shamakg/hope-pager/libs-updated/3dmodels/USB4085-GF-A_REVB.step

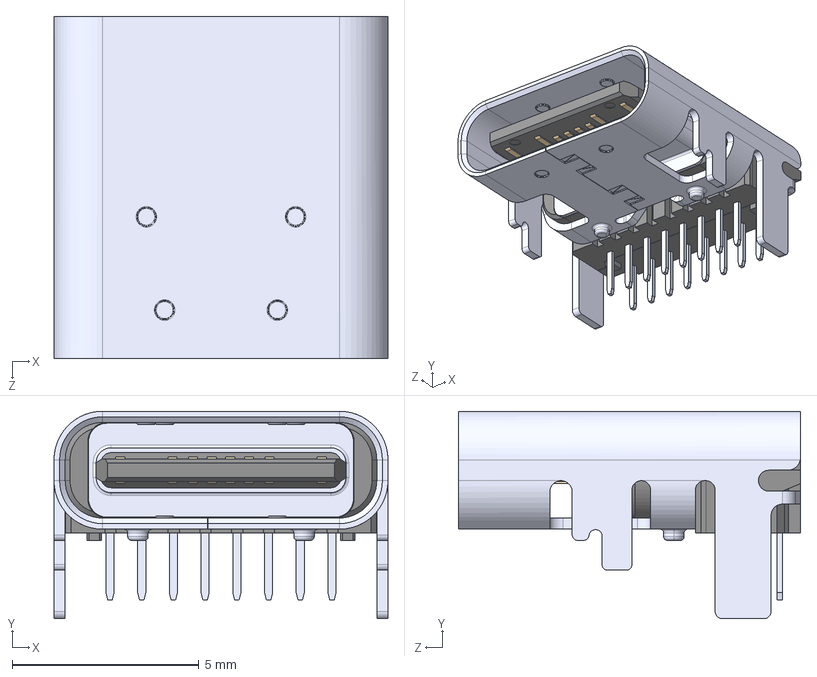
[picture p1: CAD file, 2026-10-16]
libs-updated/3dmodels/USB4085-GF-A_REVB.step
8.95 x 5.56 x 9.17 mm
