shamakg/hope-pager/libs-updated/AT-1220-TT-R.step

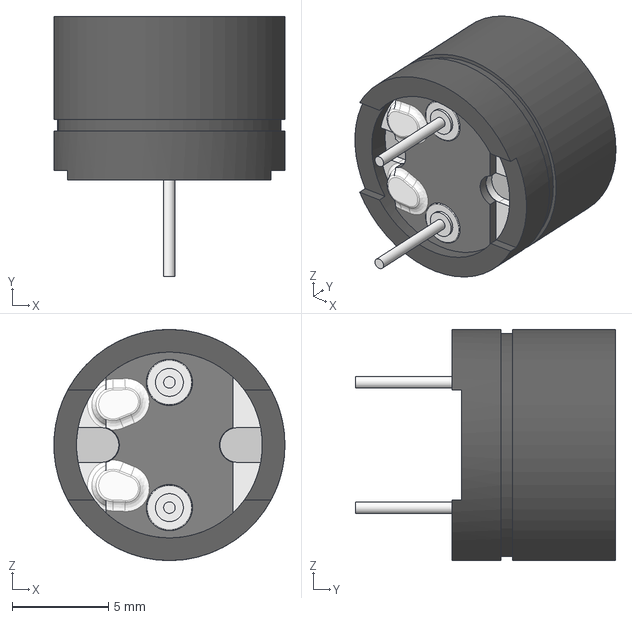
[picture p2: CAD file, 2026-10-29]
libs-updated/AT-1220-TT-R.step
12.0 x 13.5 x 12.0 mm
