shamakg/hope-pager/Pager-updated/Pager.kicad_pcb

## KiCad design Pager-updated/Pager.kicad_pcb (2026-11-06)

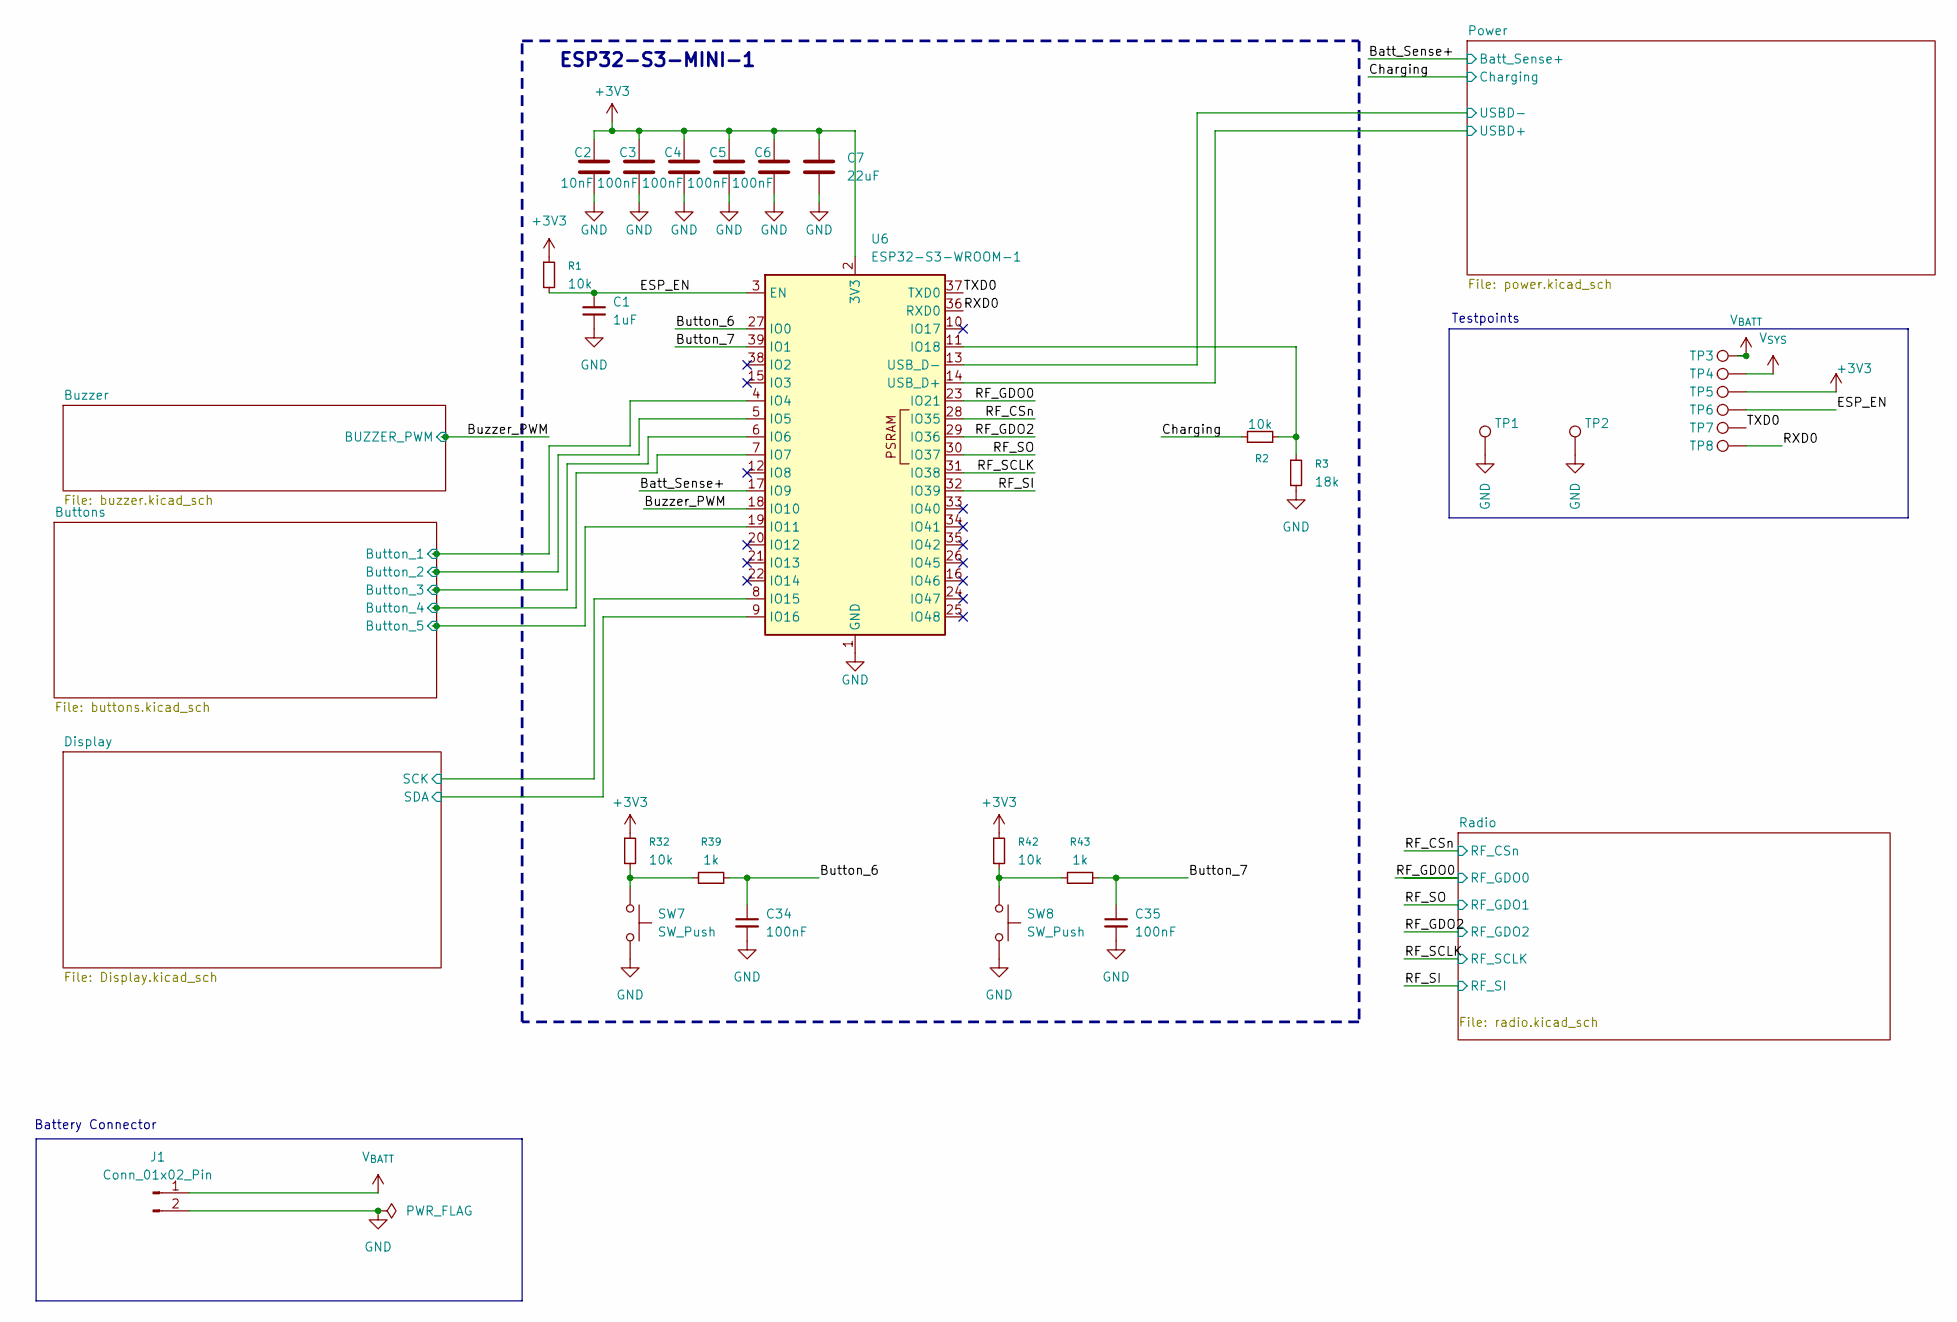
[picture p3: schematic Pager.kicad_sch]

Parts:
C1: 1uF; C_0805_2012Metric_Pad1.18x1.45mm_HandSolder
C2: 10nF; C_0805_2012Metric_Pad1.18x1.45mm_HandSolder
C3, C4, C5, C6: 100nF; C_0805_2012Metric_Pad1.18x1.45mm_HandSolder
C7: 22uF; C_0805_2012Metric_Pad1.18x1.45mm_HandSolder
C34, C35: 100nF; C_0603_1608Metric
J1: Conn_01x02_Pin; JST_PH_S2B-PH-SM4-TB_1x02-1MP_P2.00mm_Horizontal
R1, R2: 10k; R_0805_2012Metric_Pad1.20x1.40mm_HandSolder
R3: 18k; R_0805_2012Metric_Pad1.20x1.40mm_HandSolder
R32, R42: 10k; R_0603_1608Metric
R39, R43: 1k; R_0603_1608Metric
SW7, SW8: SW_Push; SW_PUSH_6mm
TP1, TP2, TP3, TP4, TP5, TP6, TP7, TP8: TestPoint; TestPoint_Pad_D1.5mm
U6: ESP32-S3-WROOM-1; ESP32-S3-WROOM-1U

Connections:
+3V3: C2.1, C3.1, C4.1, C5.1, C6.1, C7.1, R1.1, R32.1, R42.1, TP5.1 (1_1), U6.2 (3V3); also elsewhere on the board
/Batt_Sense+: U6.17 (IO9); also elsewhere on the board
/Button_6: C34.1, R39.2, U6.27 (IO0)
/Button_7: C35.1, R43.2, U6.39 (IO1)
/Buttons/Button_1: U6.4 (IO4); also elsewhere on the board
/Buttons/Button_2: U6.5 (IO5); also elsewhere on the board
/Buttons/Button_3: U6.6 (IO6); also elsewhere on the board
/Buttons/Button_4: U6.7 (IO7); also elsewhere on the board
/Buttons/Button_5: U6.19 (IO11); also elsewhere on the board
/Buzzer_PWM: U6.18 (IO10); also elsewhere on the board
/Charging: R2.1; also elsewhere on the board
/Display/SCK: U6.8 (IO15); also elsewhere on the board
/Display/SDA: U6.9 (IO16); also elsewhere on the board
/ESP_EN: C1.1, R1.2, TP6.1 (1_1), U6.3 (EN)
/Power/USBD+: U6.14 (USB_D+); also elsewhere on the board
/Power/USBD-: U6.13 (USB_D-); also elsewhere on the board
/RF_CSn: U6.28 (IO35); also elsewhere on the board
/RF_GDO0: U6.23 (IO21); also elsewhere on the board
/RF_GDO2: U6.29 (IO36); also elsewhere on the board
/RF_SCLK: U6.31 (IO38); also elsewhere on the board
/RF_SI: U6.32 (IO39); also elsewhere on the board
/RF_SO: U6.30 (IO37); also elsewhere on the board
/RXD0: TP8.1 (1_1), U6.36 (RXD0)
/TXD0: TP7.1 (1_1), U6.37 (TXD0)
GND: C1.2, C2.2, C3.2, C4.2, C5.2, C6.2, C7.2, C34.2, C35.2, J1.2, R3.2, SW7.2, SW8.2, TP1.1 (1_1), TP2.1 (1_1), U6.1 (GND), U6.40 (GND), U6.41 (GND); also elsewhere on the board
unnamed: R32.2, R39.1, SW7.1
unnamed: R42.2, R43.1, SW8.1
unnamed: R2.2, R3.1, U6.11 (IO18)
V_{BATT}: J1.1, TP3.1 (1_1); also elsewhere on the board
V_{SYS}: TP4.1 (1_1); also elsewhere on the board

Notes on the sheet:
Battery Connector
ESP32-S3-MINI-1
Testpoints

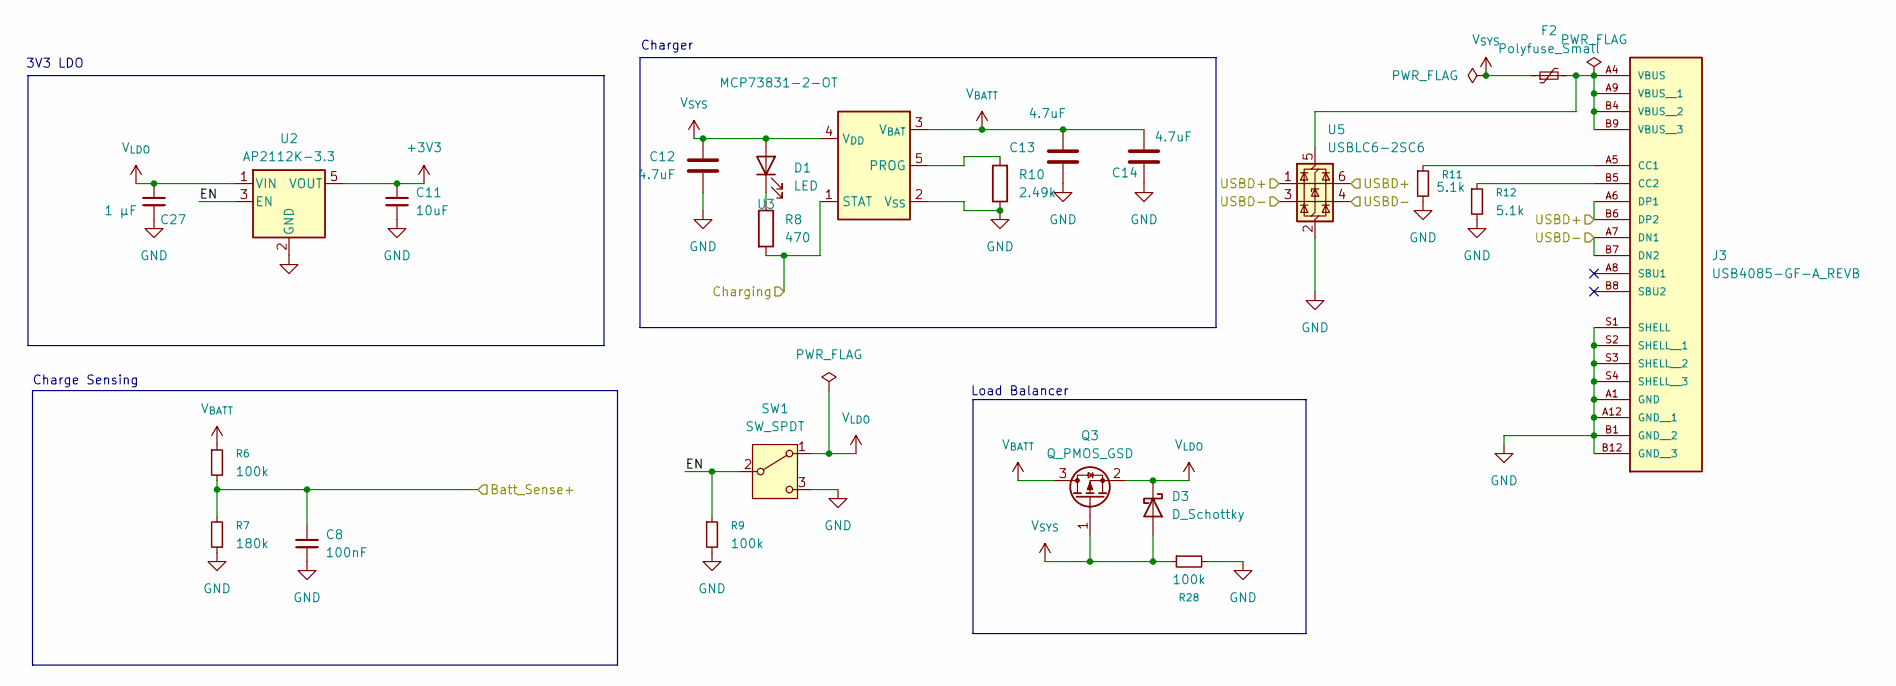
[picture p4: schematic power.kicad_sch]

Parts:
C8: 100nF; C_0805_2012Metric_Pad1.18x1.45mm_HandSolder
C11: 10uF; C_0805_2012Metric_Pad1.18x1.45mm_HandSolder
C12, C13, C14: 4.7uF; C_0805_2012Metric_Pad1.18x1.45mm_HandSolder
C27: 1 µF; C_0805_2012Metric_Pad1.18x1.45mm_HandSolder
D1: LED; LED_0603_1608Metric
D3: D_Schottky; D_SOD-123
F2: Polyfuse_Small; Fuse_1206_3216Metric
J3: USB4085-GF-A_REVB; GCT_USB4085-GF-A_REVB; PARTREV B
Q3: Q_PMOS_GSD; SOT-523
R6, R9, R28: 100k; R_0805_2012Metric_Pad1.20x1.40mm_HandSolder
R7: 180k; R_0805_2012Metric_Pad1.20x1.40mm_HandSolder
R8: 470; R_0805_2012Metric_Pad1.20x1.40mm_HandSolder
R10: 2.49k; R_0805_2012Metric_Pad1.20x1.40mm_HandSolder
R11, R12: 5.1k; R_0805_2012Metric_Pad1.20x1.40mm_HandSolder
SW1: SW_SPDT; SW_Slide_SPDT_Straight_CK_OS102011MS2Q
U2: AP2112K-3.3; SOT-23-5
U3: MCP73831-2-OT; SOT-23-5
U5: USBLC6-2SC6; SOT-23-6

Connections:
+3V3: C11.1, U2.5 (VOUT); also elsewhere on the board
/Batt_Sense+: C8.2, R6.2, R7.2; also elsewhere on the board
/Charging: R8.2, U3.1 (STAT); also elsewhere on the board
/Power/EN: R9.1, SW1.2 (B), U2.3 (EN)
/Power/USBD+: J3.A6 (DP1), J3.B6 (DP2), U5.1 (I/O1), U5.6 (I/O1); also elsewhere on the board
/Power/USBD-: J3.A7 (DN1), J3.B7 (DN2), U5.3 (I/O2), U5.4 (I/O2); also elsewhere on the board
GND: C8.1, C11.2, C12.1, C13.1, C14.1, C27.2, J3.A1 (GND), J3.A12 (GND__1), J3.B1 (GND__2), J3.B12 (GND__3), J3.S1 (SHELL), J3.S2 (SHELL__1), J3.S3 (SHELL__2), J3.S4 (SHELL__3), R7.1, R9.2, R10.1, R11.2, R12.2, R28.2, SW1.3 (C), U2.2 (GND), U3.2 (V_{SS}), U5.2 (GND); also elsewhere on the board
unnamed: D1.1 (K), R8.1
unnamed: J3.A5 (CC1), R11.1
unnamed: J3.B5 (CC2), R12.1
unnamed: F2.2, J3.A4 (VBUS), J3.A9 (VBUS__1), J3.B4 (VBUS__2), J3.B9 (VBUS__3), U5.5 (VBUS)
unnamed: R10.2, U3.5 (PROG)
V_{BATT}: C13.2, C14.2, Q3.3 (D), R6.1, U3.3 (V_{BAT}); also elsewhere on the board
V_{LDO}: C27.1, D3.1 (K), Q3.2 (S), SW1.1 (A), U2.1 (VIN)
V_{SYS}: C12.2, D1.2 (A), D3.2 (A), F2.1, Q3.1 (G), R28.1, U3.4 (V_{DD}); also elsewhere on the board

Notes on the sheet:
3V3 LDO
Load Balancer
Charge Sensing
Charger

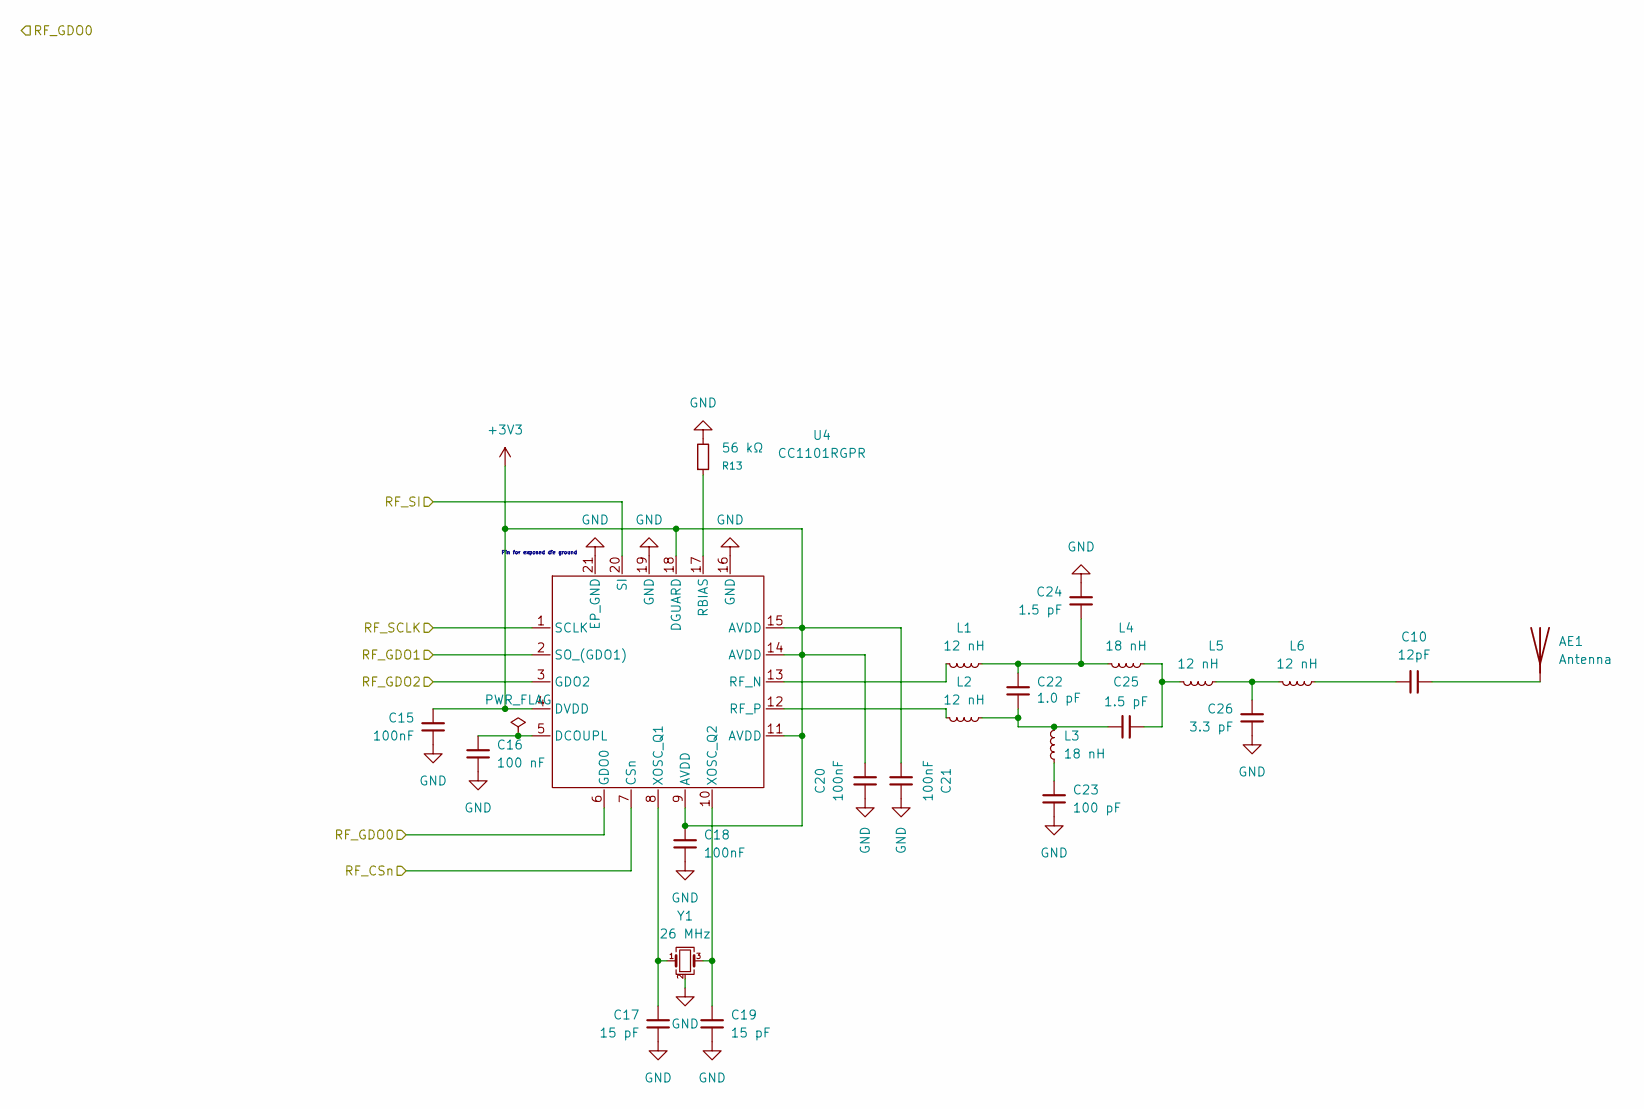
[picture p5: schematic radio.kicad_sch]

Parts:
AE1: Antenna; ANT_0915AT43A0026E_JOT
C10: 12pF; C_0805_2012Metric_Pad1.18x1.45mm_HandSolder
C15, C18, C20, C21: 100nF; C_0805_2012Metric_Pad1.18x1.45mm_HandSolder
C16: 100 nF; C_0805_2012Metric_Pad1.18x1.45mm_HandSolder
C17, C19: 15 pF; C_0805_2012Metric_Pad1.18x1.45mm_HandSolder
C22: 1.0 pF; C_0805_2012Metric_Pad1.18x1.45mm_HandSolder
C23: 100 pF; C_0805_2012Metric_Pad1.18x1.45mm_HandSolder
C24, C25: 1.5 pF; C_0805_2012Metric_Pad1.18x1.45mm_HandSolder
C26: 3.3 pF; C_0805_2012Metric_Pad1.18x1.45mm_HandSolder
L1, L2, L5, L6: 12 nH; L_0805_2012Metric_Pad1.05x1.20mm_HandSolder
L3, L4: 18 nH; L_0805_2012Metric_Pad1.05x1.20mm_HandSolder
R13: 56 kΩ; R_0805_2012Metric_Pad1.20x1.40mm_HandSolder
U4: CC1101RGPR; Texas_RGP0020H_VQFN-20-1EP_4x4mm_P0.5mm_EP2.4x2.4mm_Thermal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
Y1: 26 MHz; Crystal_SMD_3225-4Pin_3.2x2.5mm

Connections:
+3V3: C15.1, C18.1, C20.2, C21.1, U4.4 (DVDD), U4.9 (AVDD), U4.11 (AVDD), U4.14 (AVDD), U4.15 (AVDD), U4.18 (DGUARD); also elsewhere on the board
/RF_CSn: U4.7 (CSn); also elsewhere on the board
/RF_GDO0: U4.6 (GDO0); also elsewhere on the board
/RF_GDO2: U4.3 (GDO2); also elsewhere on the board
/RF_SCLK: U4.1 (SCLK); also elsewhere on the board
/RF_SI: U4.20 (SI); also elsewhere on the board
/RF_SO: U4.2 (SO_(GDO1)); also elsewhere on the board
GND: C15.2, C16.2, C17.2, C18.2, C19.2, C20.1, C21.2, C23.2, C24.2, C26.1, R13.2, U4.16 (GND), U4.19 (GND), U4.21 (EP_GND), Y1.2 (G), Y1.4 (G); also elsewhere on the board
unnamed: AE1.1 (A_1), C10.2
unnamed: C10.1, L6.1
unnamed: C22.1, C24.1, L1.1, L4.2
unnamed: C22.2, C25.1, L2.1, L3.2
unnamed: C23.1, L3.1
unnamed: C25.2, L4.1, L5.2
unnamed: C26.2, L5.1, L6.2
unnamed: C16.1, U4.5 (DCOUPL)
unnamed: R13.1, U4.17 (RBIAS)
unnamed: L1.2, U4.13 (RF_N)
unnamed: L2.2, U4.12 (RF_P)
unnamed: C17.1, U4.8 (XOSC_Q1), Y1.1
unnamed: C19.1, U4.10 (XOSC_Q2), Y1.3

Notes on the sheet:
Pin for exposed die ground

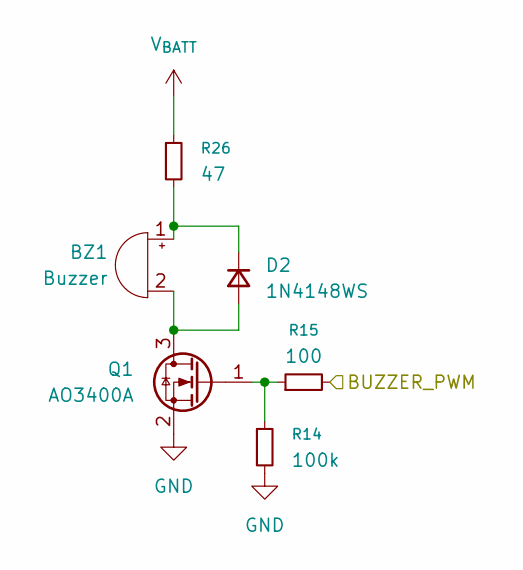
[picture p6: schematic buzzer.kicad_sch]

Parts:
BZ1: Buzzer; XDCR_AT-1220-TT-R
D2: 1N4148WS; D_SOD-323
Q1: AO3400A; SOT-23
R14: 100k; R_0805_2012Metric_Pad1.20x1.40mm_HandSolder
R15: 100; R_0805_2012Metric_Pad1.20x1.40mm_HandSolder
R26: 47; R_0805_2012Metric_Pad1.20x1.40mm_HandSolder

Connections:
/Buzzer_PWM: R15.2; also elsewhere on the board
GND: Q1.2 (S), R14.2; also elsewhere on the board
unnamed: BZ1.1 (+), D2.1 (K), R26.2
unnamed: BZ1.2 (-), D2.2 (A), Q1.3 (D)
unnamed: Q1.1 (G), R14.1, R15.1
V_{BATT}: R26.1; also elsewhere on the board

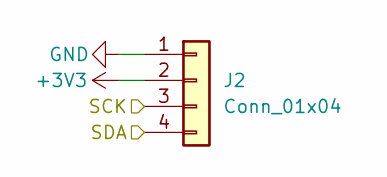
[picture p7: schematic Display.kicad_sch]

Parts:
J2: Conn_01x04; PinHeader_1x04_P2.54mm_Vertical

Connections:
+3V3: J2.2; also elsewhere on the board
/Display/SCK: J2.3; also elsewhere on the board
/Display/SDA: J2.4; also elsewhere on the board
GND: J2.1; also elsewhere on the board

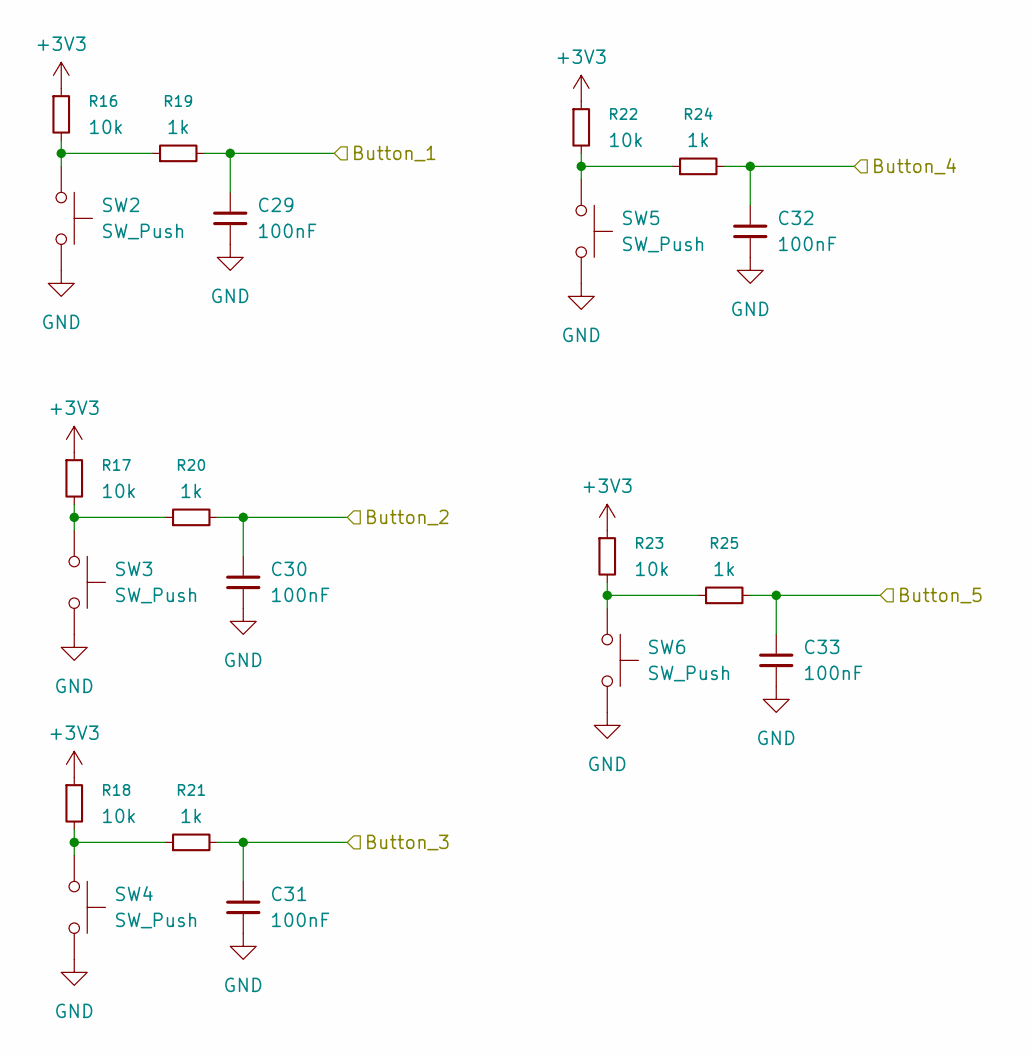
[picture p8: schematic buttons.kicad_sch]

Parts:
C29, C30, C31, C32, C33: 100nF; C_0805_2012Metric_Pad1.18x1.45mm_HandSolder
R16, R17, R18, R22, R23: 10k; R_0805_2012Metric_Pad1.20x1.40mm_HandSolder
R19, R20, R21, R24, R25: 1k; R_0805_2012Metric_Pad1.20x1.40mm_HandSolder
SW2, SW3, SW4, SW5, SW6: SW_Push; SW_PUSH_6mm

Connections:
+3V3: R16.1, R17.1, R18.1, R22.1, R23.1; also elsewhere on the board
/Buttons/Button_1: C29.1, R19.2; also elsewhere on the board
/Buttons/Button_2: C30.1, R20.2; also elsewhere on the board
/Buttons/Button_3: C31.1, R21.2; also elsewhere on the board
/Buttons/Button_4: C32.1, R24.2; also elsewhere on the board
/Buttons/Button_5: C33.1, R25.2; also elsewhere on the board
GND: C29.2, C30.2, C31.2, C32.2, C33.2, SW2.2, SW3.2, SW4.2, SW5.2, SW6.2; also elsewhere on the board
unnamed: R16.2, R19.1, SW2.1
unnamed: R17.2, R20.1, SW3.1
unnamed: R18.2, R21.1, SW4.1
unnamed: R22.2, R24.1, SW5.1
unnamed: R23.2, R25.1, SW6.1

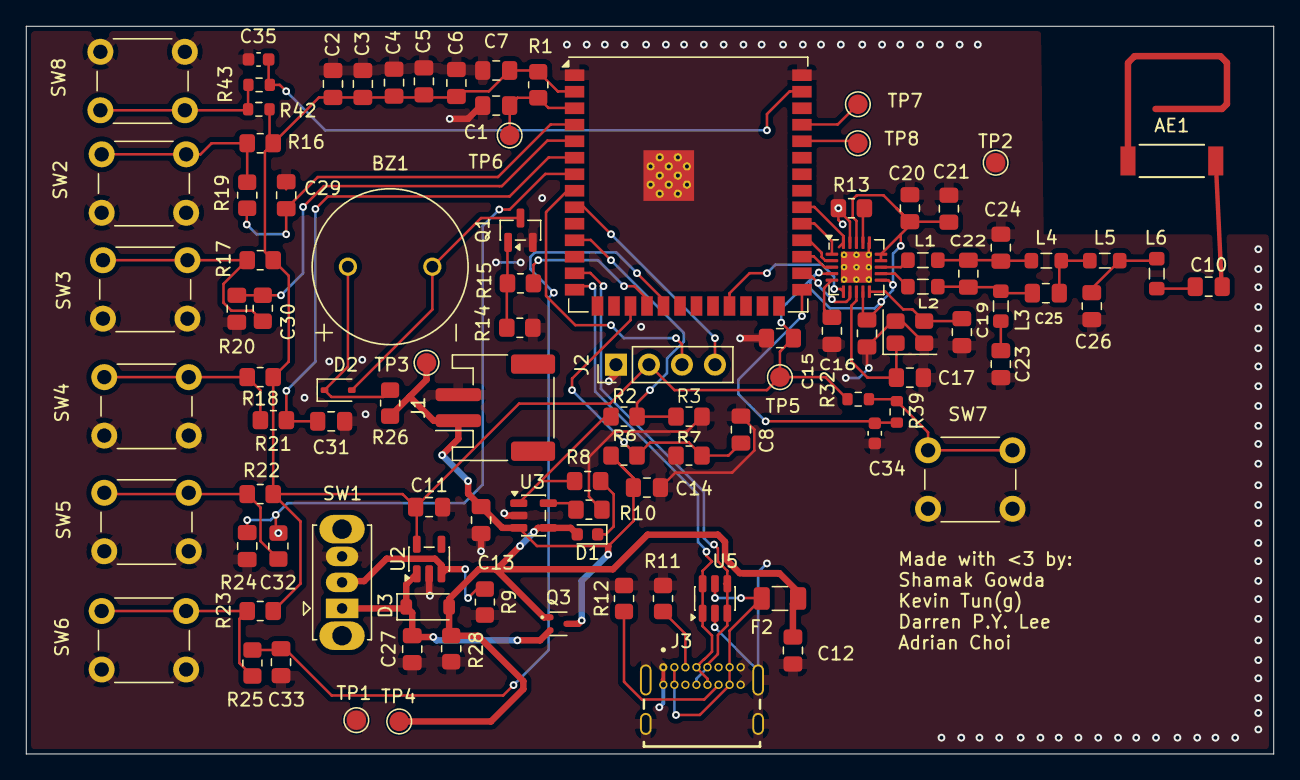
[picture p9: board Pager.kicad_pcb from above]

Board: 2 copper layers, 96.0 x 56.0 mm, 101 parts (0 on the bottom side), 58 nets.
