shamakg/hope-pager/(commit log)

2026-10-16 esp32 + crystal
    [Pager.kicad_pcb, Pager.kicad_sch, Untitled.kicad_pcb, Untitled.kicad_sch]
2026-10-16 removed Untitled
    [Untitled.kicad_pcb, Untitled.kicad_sch]
2026-10-16 bring all project files up a level
    [Pager.kicad_pcb, Pager.kicad_sch, power.kicad_sch]
2026-10-22 created new radio symbol and started on radio schem
    [radio.kicad_sch]
2026-10-23 add cap values
    [radio.kicad_sch]
2026-10-23 finish radio ic
    [radio.kicad_sch]
2026-10-23 finished radio module
    [Pager.kicad_sch, radio.kicad_sch]
2026-10-23 connected radio to mcu
    [Pager.kicad_sch, radio.kicad_sch]
2026-10-29 Schematic Review, Footprints Added, Need Screen
    [Display.kicad_sch, Pager.kicad_sch, buttons.kicad_sch, buzzer.kicad_sch, power.kicad_sch, radio.kicad_sch]
2026-10-30 add display module
    [Display.kicad_sch, Pager.kicad_sch]
2026-11-06 fixed power load balancing circuit
    [power.kicad_sch]
2026-11-06 fix vbus det line
    [Pager.kicad_sch, power.kicad_sch]
2026-11-06 fix radio schematic
    [Pager.kicad_sch, radio.kicad_sch]
2026-11-06 remove vbus detect
    [Pager.kicad_pcb, Pager.kicad_sch, power.kicad_sch]
2026-11-06 updated esp schematic
    [Pager.kicad_sch]
2026-11-06 manufacturing files and small fixes
    [Pager-B_Cu.gbr, Pager-B_Mask.gbr, Pager-B_Paste.gbr, Pager-B_Silkscreen.gbr, Pager-Edge_Cuts.gbr, Pager-F_Cu.gbr, Pager-F_Mask.gbr, Pager-F_Paste.gbr]
2026-11-06 remove unused components
    [Pager.kicad_pcb]
2026-11-06 final manufacturing files
    [Pager-B_Cu.gbr, Pager-B_Mask.gbr, Pager-B_Paste.gbr, Pager-B_Silkscreen.gbr, Pager-Edge_Cuts.gbr, Pager-F_Cu.gbr, Pager-F_Mask.gbr, Pager-F_Paste.gbr]
